ScottCampbellBoise/Muon-Detector-Files/Detector Circuit Outline.png

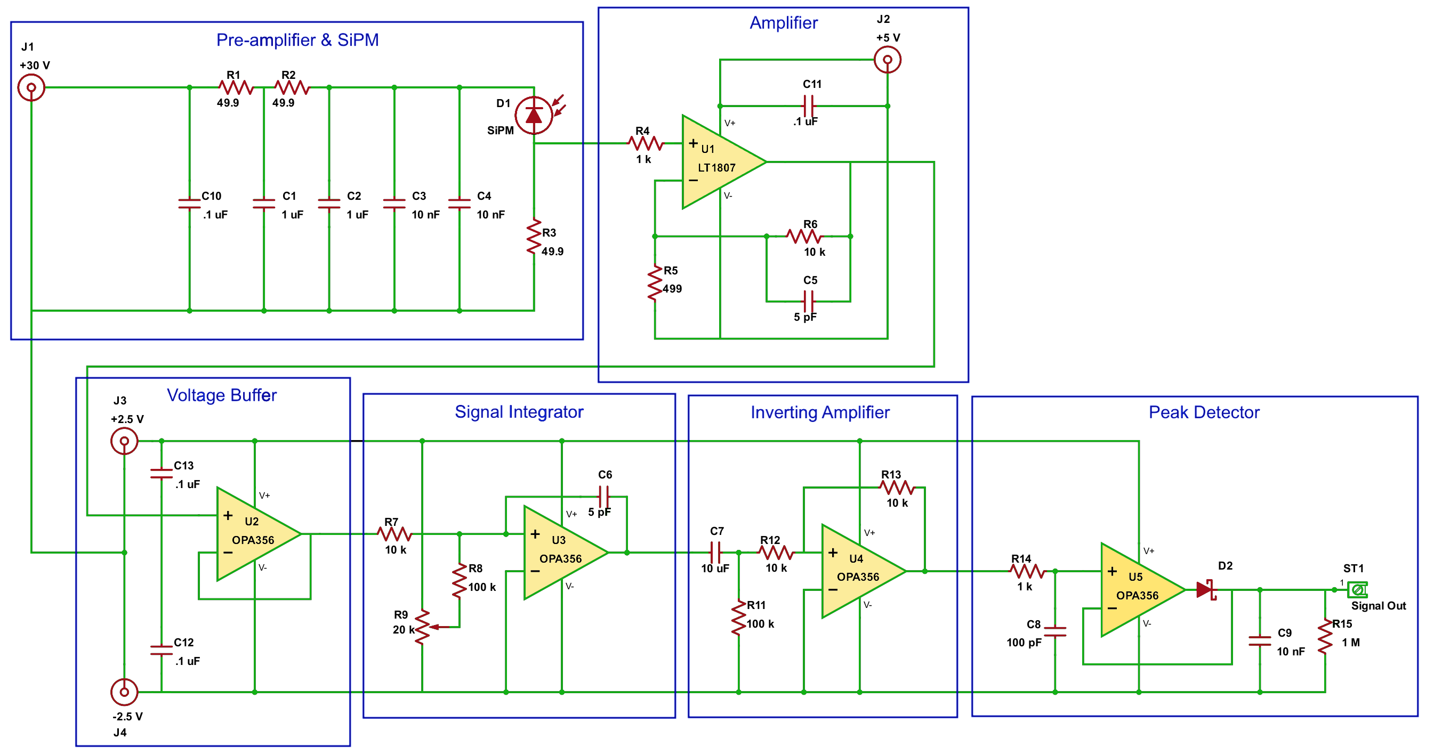
Detector Circuit Outline.png
