ScottCampbellBoise/Muon-Detector-Files/Detector Materials List.xlsx

Part Name | Part Type | Value | Digi-Key Part Number | Min. Quantity | Description | Comments
C1, C2 | NON POLARIZED | 1 uF | 490-9146-1-ND | 2 | VARIANT 1
C3, C4, C9 | NON POLARIZED | 10 nF | 445-173587-1-ND | 3 | VARIANT 1
R1, R2, R3 | RESISTOR | 49.9 | 49.9XBK-ND | 3 | GENERAL
R4, R14 | RESISTOR | 1 k | S1KCACT-ND | 2 | GENERAL
R5 | RESISTOR | 499 | RNF14FTD499RCT-ND | 1 | GENERAL
R6 | RESISTOR | 10 k | RNF14FTD10K0CT-ND | 1 | GENERAL
C5, C6 | NON POLARIZED | 5 pF | 445-173467-1-ND | 2 | VARIANT 1
R7, R12, R13 | RESISTOR | 10 k | RNF14FTD10K0CT-ND | 3 | GENERAL
R8, R11, R15 | RESISTOR | 100 k | RNF14FTD100KCT-ND | 3 | GENERAL
R9 | VARIABLE | 20 k | T93YB-20K-ND | 1 | GENERAL
C7 | NON POLARIZED | 10 uF | 445-173132-1-ND | 1 | VARIANT 1
C8 | NON POLARIZED | 100 pF | BC1013CT-ND | 1 | VARIANT 1
D2 | SCHOTTKY |  | MBR0540CT-ND | 1 | VARIANT 2
C10, C11, C12, C13 | NON POLARIZED | 0.1 uF | BC1160CT-ND | 4 | VARIANT 1
U1 | LT1807 |  | LT1807CS8#PBF-ND | 1 | Single Supply Op Amp | *
U2, U3, U4, U5 | OPA356 |  | 296-32191-1-ND | 4 | Dual Supply Op Amp | **
SOIC-8 Adapter |  |  | ‎9082CA-ND‎ | 1 | SMD to DIP adapter | ** Allows for the surface mount op amp to be converted to a through-hole piece for use on a perforated breadboard
SOT-23-5 Adapter |  |  | ‎33205CA-ND‎ | 4 | SMD to DIP adapter | ** Allows for the surface mount op amp to be converted to a through-hole piece for use on a perforated breadboard
Solderable Breadboard |  |  | SBB830-ND | 1
BC-408 Scintillator |  |  |  |  |  | https://www.ebay.com/itm/Bicron-BC-408-Plastic-Scintillator-2-diameter-by-1-5-length-50mm-X-38mm/252323643214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
Ketek 33xx SiPM |  |  |  |  |  | https://www.ketek.net/store/products/pm33xx-wb/
This is a list of the parts purchased for the initial design of our detector, it does NOT represent the lowest cost for which these pieces can be purchased for.
It should also be noted that the Minimum Quantity represents the absoloute minimum number of the parts needed, we would recommend that in general, an additional 50% to 100% would be advisable for prototyping purposes,
The cost of the indivitual components is relatively minimal and can save re-ordering and potential headaches down the line.
