ScottCampbellBoise/Muon-Detector-Files/(commit log)

2019-01-07 Updated Materials List
    [Cosmic-Ray-Detector-Materials-List.xlsx]
2019-01-07 Updated Detector Materials List
    [Detector Materials List.xlsx]
2019-07-18 Updated the time tracking variable to give the current time in millis
